vvviperrr/nrf24_remote_car/receiver_kicad/receiver.kicad_pcb

## KiCad design receiver_kicad/receiver.kicad_pcb (2019-10-18)

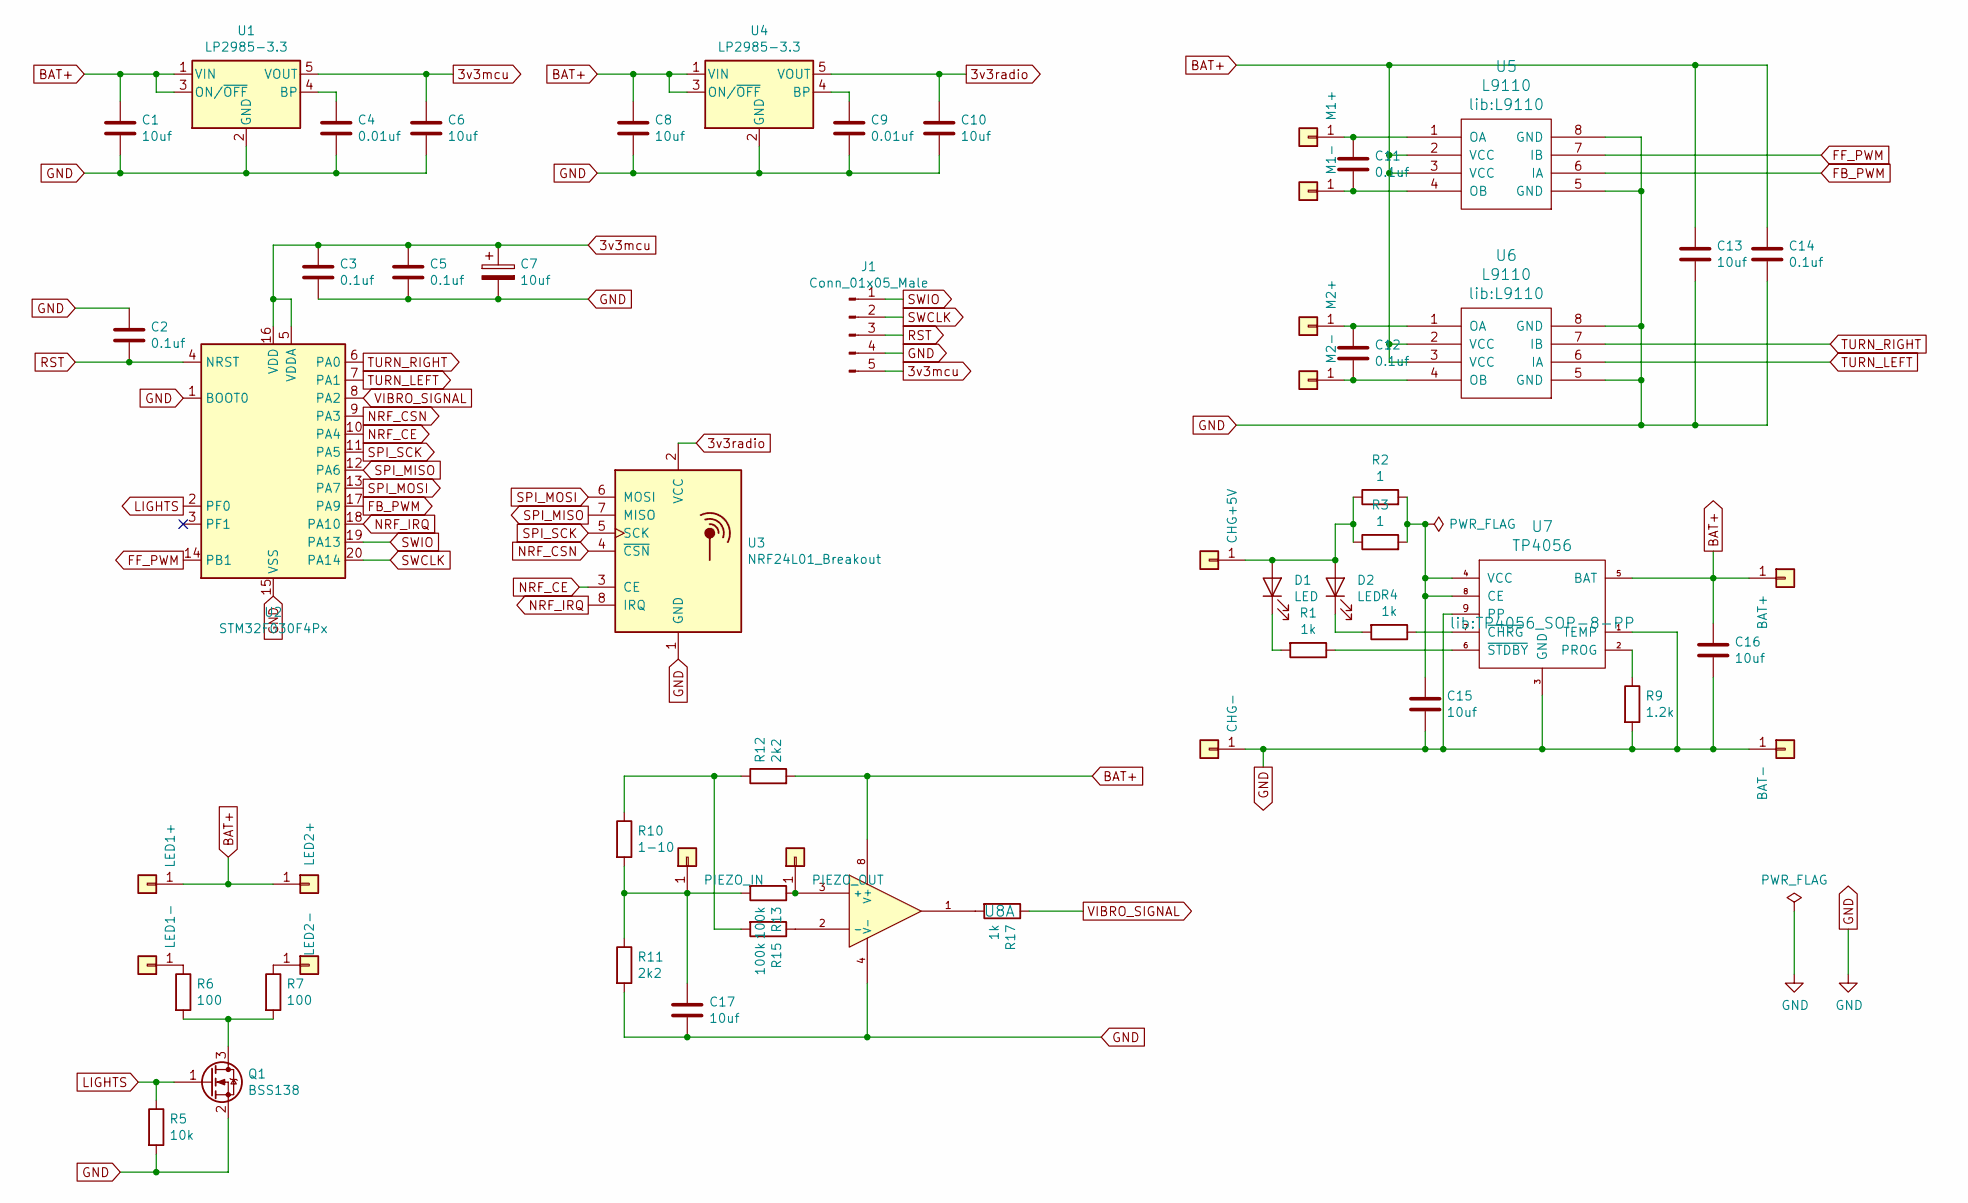
[picture p1: schematic receiver.sch]

Parts:
C1, C6, C8, C10, C13, C15, C16, C17: 10uf; C_0805_2012Metric_Pad1.15x1.40mm_HandSolder
C2: 0.1uf; C_0603_1608Metric_Pad1.05x0.95mm_HandSolder
C3, C5, C11, C12, C14: 0.1uf; C_0805_2012Metric_Pad1.15x1.40mm_HandSolder
C4, C9: 0.01uf; C_0805_2012Metric_Pad1.15x1.40mm_HandSolder
C7: 10uf; CP_EIA-3216-18_Kemet-A_Pad1.58x1.35mm_HandSolder
D1, D2: LED; LED_0603_1608Metric_Pad1.05x0.95mm_HandSolder
J1: Conn_01x05_Male; PinHeader_1x05_P2.54mm_Vertical
J2: M1+; TestPoint_THTPad_4.0x4.0mm_Drill2.0mm
J3: M1-; TestPoint_THTPad_4.0x4.0mm_Drill2.0mm
J4: M2+; TestPoint_THTPad_4.0x4.0mm_Drill2.0mm
J5: M2-; TestPoint_THTPad_4.0x4.0mm_Drill2.0mm
J6: CHG+5V; TestPoint_THTPad_4.0x4.0mm_Drill2.0mm
J7: CHG-; TestPoint_THTPad_4.0x4.0mm_Drill2.0mm
J8: BAT+; TestPoint_THTPad_4.0x4.0mm_Drill2.0mm
J9: BAT-; TestPoint_THTPad_4.0x4.0mm_Drill2.0mm
J10: PIEZO_IN; TestPoint_THTPad_4.0x4.0mm_Drill2.0mm
J11: PIEZO_OUT; TestPoint_THTPad_4.0x4.0mm_Drill2.0mm
J12: LED1+; TestPoint_THTPad_4.0x4.0mm_Drill2.0mm
J13: LED1-; TestPoint_THTPad_4.0x4.0mm_Drill2.0mm
J14: LED2+; TestPoint_THTPad_4.0x4.0mm_Drill2.0mm
J15: LED2-; TestPoint_THTPad_4.0x4.0mm_Drill2.0mm
Q1: BSS138; SOT-23
R1, R4, R17: 1k; R_0603_1608Metric_Pad1.05x0.95mm_HandSolder
R2, R3: 1; R_0805_2012Metric_Pad1.15x1.40mm_HandSolder
R5: 10k; R_0603_1608Metric_Pad1.05x0.95mm_HandSolder
R6, R7: 100; R_0603_1608Metric_Pad1.05x0.95mm_HandSolder
R9: 1.2k; R_0603_1608Metric_Pad1.05x0.95mm_HandSolder
R10: 1-10; R_0603_1608Metric_Pad1.05x0.95mm_HandSolder
R11, R12: 2k2; R_0603_1608Metric_Pad1.05x0.95mm_HandSolder
R13, R15: 100k; R_0603_1608Metric_Pad1.05x0.95mm_HandSolder
U1, U4: LP2985-3.3; SOT-23-5_HandSoldering
U2: STM32F030F4Px; TSSOP-20_4.4x6.5mm_P0.65mm
U3: NRF24L01_Breakout; NRF24L01-SMD
U5, U6: L9110
U7: TP4056; TP4056_SOP-8-PP
U8: LM358; SOIC-8_3.9x4.9mm_P1.27mm

Connections:
3v3mcu: C3.1, C5.1, C6.1, C7.1, J1.5, U1.5 (VOUT), U2.5 (VDDA), U2.16 (VDD)
3v3radio: C10.1, U3.2 (VCC), U4.5 (VOUT)
BAT+: C1.1, C8.1, C13.1, C14.1, C16.1, J8.1, J12.1, J14.1, R12.2, U1.1 (VIN), U1.3 (ON/~OFF~), U4.1 (VIN), U4.3 (ON/~OFF~), U5.2 (VCC), U5.3 (VCC), U6.2 (VCC), U6.3 (VCC), U7.5 (BAT), U8.8 (V+)
FB_PWM: U2.17 (PA9), U5.6 (IA)
FF_PWM: U2.14 (PB1), U5.7 (IB)
GND: C1.2, C2.1, C3.2, C4.2, C5.2, C6.2, C7.2, C8.2, C9.2, C10.2, C13.2, C14.2, C15.2, C16.2, C17.2, J1.4, J7.1, J9.1, Q1.2 (S), R5.2, R9.2, R11.2, U1.2 (GND), U2.1 (BOOT0), U2.15 (VSS), U3.1 (GND), U4.2 (GND), U5.5 (GND), U5.8 (GND), U6.5 (GND), U6.8 (GND), U7.1 (TEMP), U7.3 (GND), U7.9 (PP), U8.4 (V-)
LIGHTS: Q1.1 (G), R5.1, U2.2 (PF0)
NRF_CE: U2.10 (PA4), U3.3 (CE)
NRF_CSN: U2.9 (PA3), U3.4 (~CSN)
NRF_IRQ: U2.18 (PA10), U3.8 (IRQ)
unnamed: C4.1, U1.4 (BP)
unnamed: C9.1, U4.4 (BP)
unnamed: C11.1, J2.1, U5.1 (OA)
unnamed: C11.2, J3.1, U5.4 (OB)
unnamed: C12.1, J4.1, U6.1 (OA)
unnamed: C12.2, J5.1, U6.4 (OB)
unnamed: C15.1, R2.2, R3.2, U7.4 (VCC), U7.8 (CE)
unnamed: C17.1, J10.1, R10.2, R11.1, R13.2
unnamed: D1.1 (K), R1.2
unnamed: D1.2 (A), D2.2 (A), J6.1, R2.1, R3.1
unnamed: D2.1 (K), R4.2
unnamed: J11.1, R13.1, U8.3 (+)
unnamed: J13.1, R6.1
unnamed: J15.1, R7.1
unnamed: Q1.3 (D), R6.2, R7.2
unnamed: R1.1, U7.6 (~STDBY)
unnamed: R4.1, U7.7 (~CHRG)
unnamed: R9.1, U7.2 (PROG)
unnamed: R10.1, R12.1, R15.2
unnamed: R15.1, U8.2 (-)
unnamed: R17.2, U8.1
RST: C2.2, J1.3, U2.4 (NRST)
SPI_MISO: U2.12 (PA6), U3.7 (MISO)
SPI_MOSI: U2.13 (PA7), U3.6 (MOSI)
SPI_SCK: U2.11 (PA5), U3.5 (SCK)
SWCLK: J1.2, U2.20 (PA14)
SWIO: J1.1, U2.19 (PA13)
TURN_LEFT: U2.7 (PA1), U6.6 (IA)
TURN_RIGHT: U2.6 (PA0), U6.7 (IB)
VIBRO_SIGNAL: R17.1, U2.8 (PA2)

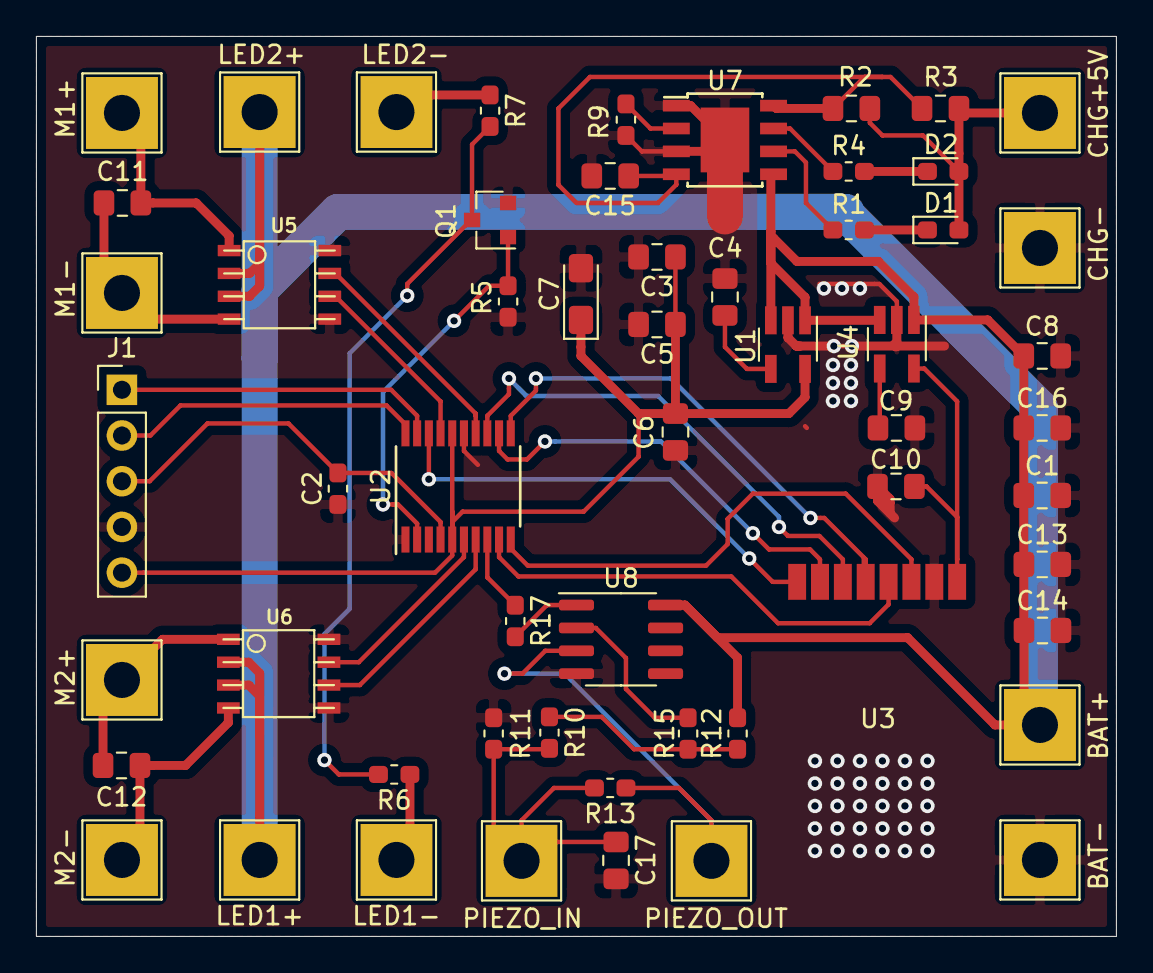
[picture p2: board receiver.kicad_pcb from above]

Board: 2 copper layers, 60.0 x 50.0 mm, 57 parts (0 on the bottom side), 40 nets.
