vvviperrr/nrf24_remote_car/receiver_firmware/receiver_firmware.ioc

Mcu.UserName=STM32F030F4Px
PA0.Signal=GPIO_Output
PA1.Signal=GPIO_Output
PA10.Signal=GPIO_Input
PA13.Signal=SYS_SWDIO
PA14.Signal=SYS_SWCLK
PA2.Signal=ADC_IN2
PA3.Signal=GPIO_Output
PA4.Signal=GPIO_Output
PA5.Signal=SPI1_SCK
PA6.Signal=SPI1_MISO
PA7.Signal=SPI1_MOSI
PA9.Signal=S_TIM1_CH2
PB1.Signal=S_TIM3_CH4
PF0-OSC_IN.Signal=GPIO_Output
