vvviperrr/nrf24_remote_car/(commit log)

2019-10-11 receiver initial commit
    [receiver.kicad_pcb, receiver.sch]
2019-10-11 more stuff added
    [receiver.kicad_pcb, receiver.sch]
2019-10-12 place done
    [receiver.kicad_pcb, receiver.sch]
2019-10-13 almost routed
    [receiver.kicad_pcb]
2019-10-14 optocouples removed
    [receiver.kicad_pcb, receiver.sch]
2019-10-15 new route done
    [receiver.kicad_pcb, receiver.sch]
2019-10-15 mosfets added, piezo scheme added
    [receiver.kicad_pcb, receiver.sch]
2019-10-16 piezo route done
    [receiver.kicad_pcb, receiver.sch]
2019-10-16 mosfets removed, now use pure pwm signals
    [receiver.kicad_pcb, receiver.sch]
2019-10-18 lights added, new route complete
    [receiver.kicad_pcb, receiver.sch]
2019-10-18 layout refactored, logos added
    [receiver.kicad_pcb, receiver.sch]
2019-10-18 project renamed
    [receiver.kicad_pcb, receiver.sch]
